Elyes-Grati/VTOL-system/docs/vtol_presentation.pdf

# VTOL

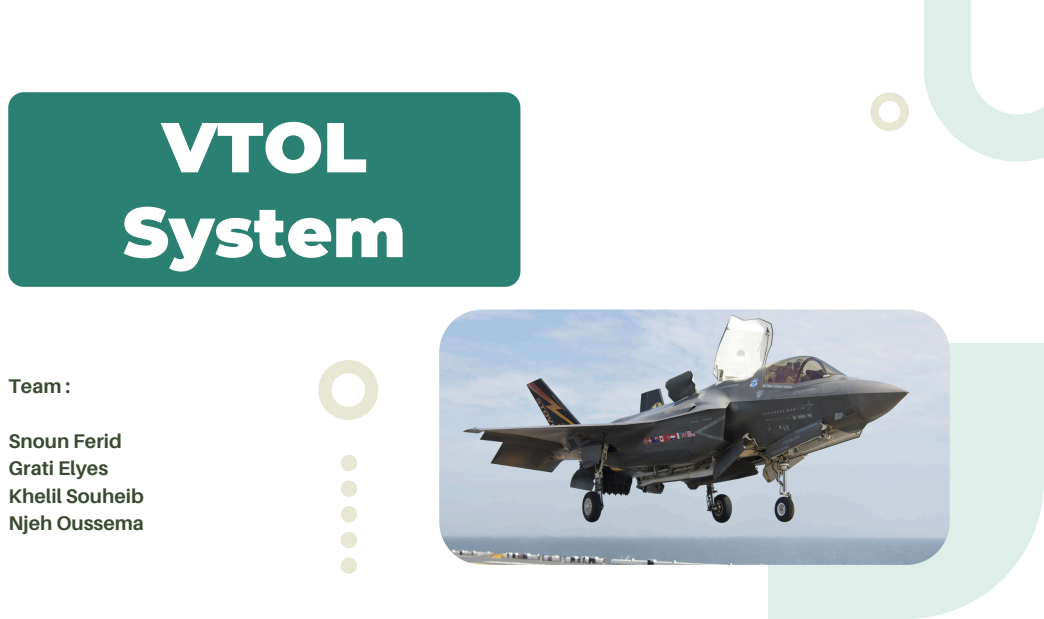
[picture p3: page 1]
System; Team :; Snoun Ferid Grati Elyes Khelil Souheib Njeh Oussema

# Who We Are: Team Introduction

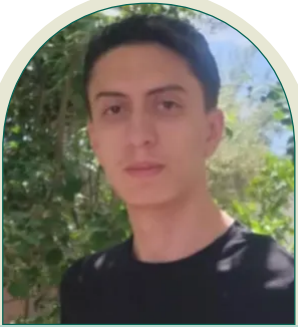
[picture p4: figure]
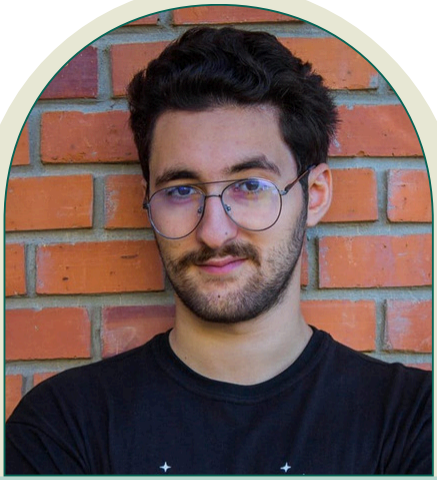
[picture p5: figure]

# IIA4

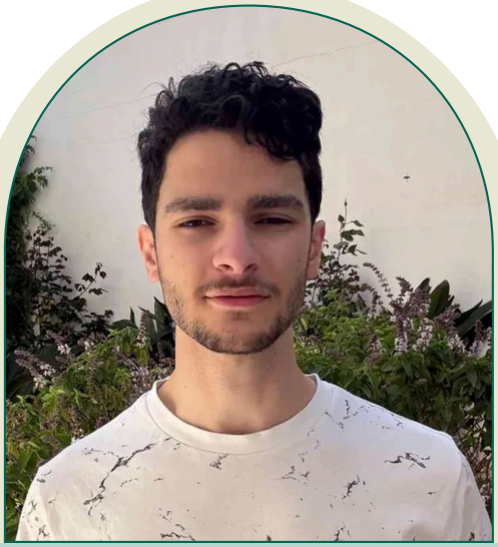
[picture p6: figure]
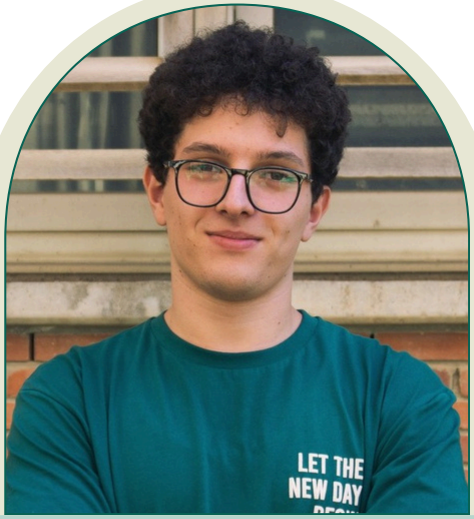
[picture p7: figure]

GRATI Elyes | NJEH Oussema | SNOUN Ferid | KHELIL Souheib

Introduction

# What Is VTOL?

VTOL stands for Vertical
Take-Off and Landing. Unlike traditional fixed-wing aircraft that require long runways to generate lift, VTOL systems can hover, take off, and land vertically.

This is achieved by orienting thrust vectors upward to
overcome | gravity | (mg)
directly. | The | benchmark
described in this document uses two thrust sources (M1 and M2) to manage both lift and roll .

# Industrial Interest and Technical Challenges

### 1. Industrial Interest

Operational Flexibility : VTOL systems eliminate the need for massive infrastructure (runways), making them ideal for urban air mobility, search and rescue in rugged terrain, and military operations on small ship decks.
Efficiency in Transition : These systems aim to combine the hovering capabilities of a helicopter with the high-speed cruise efficiency of an airplane.
Precision Logistics : They are increasingly used in the drone industry for "last-mile" delivery and autonomous inspection of industrial sites.

Strong Input Coupling : As noted in the references, VTOL systems often suffer from "Strong Input Coupling"
, where the forces intended for lift also affect the lateral movement and roll, making them difficult to stabilize.
Underactuated Dynamics : The system has fewer control inputs than degrees of freedom, requiring complex control laws to maintain balance.
Nonlinearities : Factors such as the angle of thrust and the changing roll angle create nonlinear equations of motion that are sensitive to external disturbances like wind.

# Industrial Interest and Technical Challenges

2.Technical Challenges

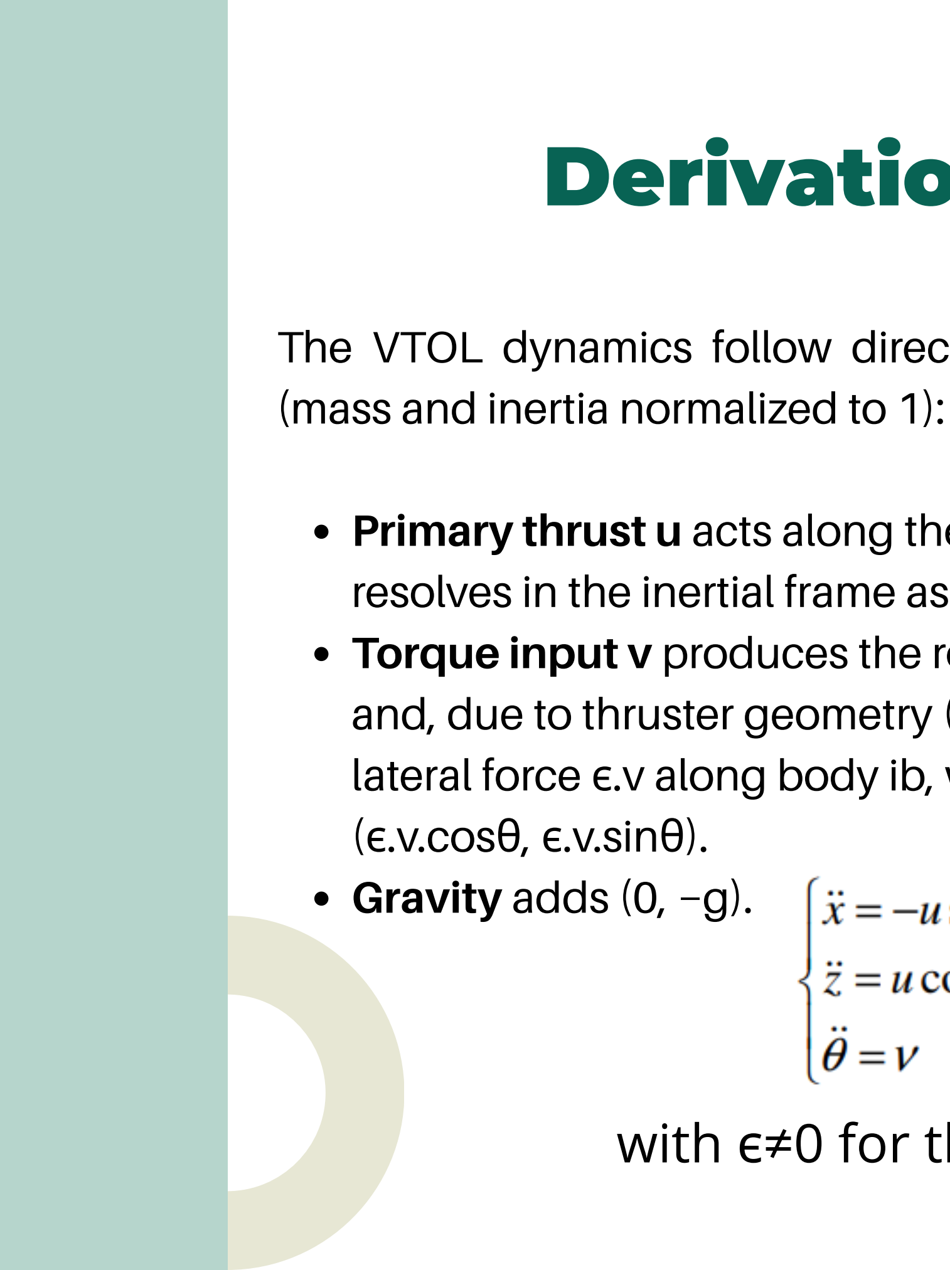
[picture p8: figure]
(mass and inertia normalized to 1):; (ϵ.v.cosθ, ϵ.v.sinθ). Gravity adds (0, −g).

The VTOL dynamics follow directly from Newton’s laws

Primary thrust u acts along the body vertical kb, which resolves in the inertial frame as (−u.sinθ, u.cosθ) . Torque input v produces the rolling acceleration = v and, due to thruster geometry (α), a small parasitic lateral force ϵ.v along body ib, which resolves as

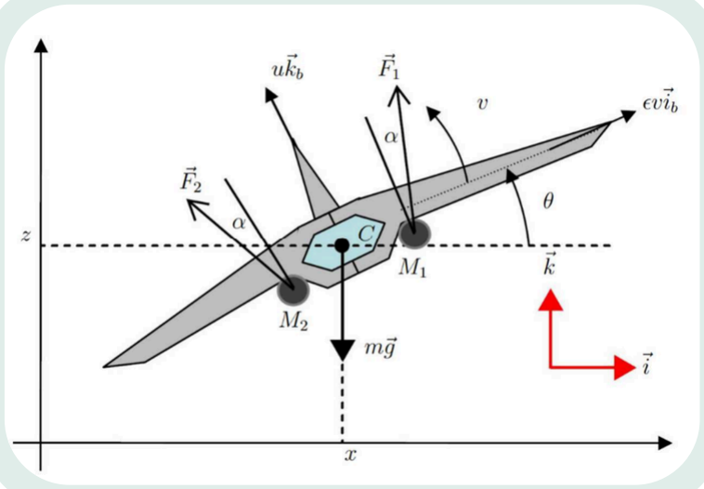
[picture p9: figure]
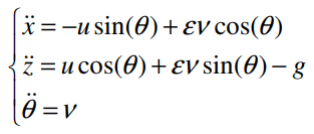
[picture p10: figure]

## with ϵ≠0 for the strong input coupling

# Derivation of the dynamics

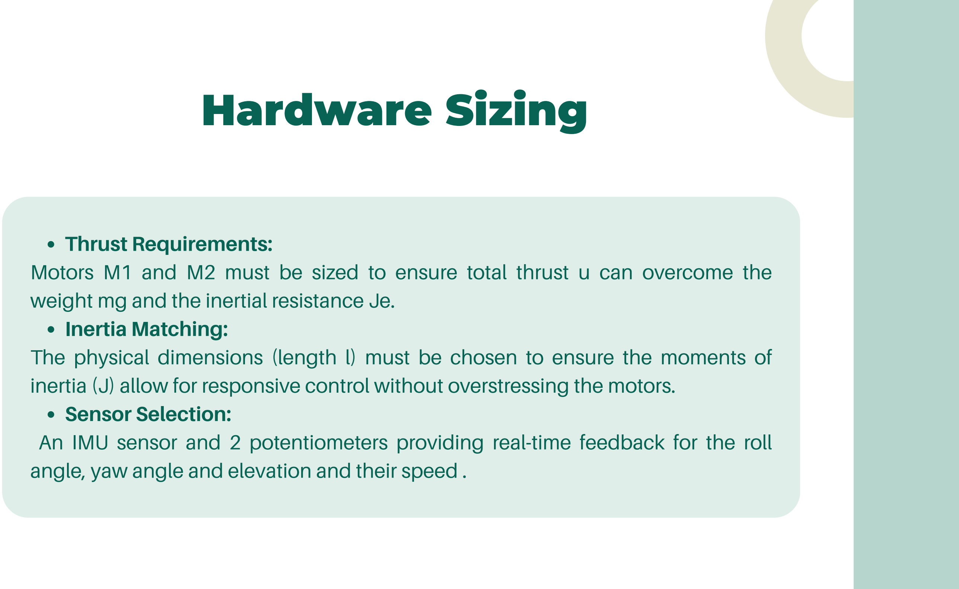
[picture p11: figure]
Hardware Sizing; Thrust Requirements:; Inertia Matching:; Sensor Selection:

Motors M1 and M2 must be sized to ensure total thrust u can overcome the weight mg and the inertial resistance Je.

The physical dimensions (length l) must be chosen to ensure the moments of inertia (J) allow for responsive control without overstressing the motors.

An IMU sensor and 2 potentiometers providing real-time feedback for the roll angle, yaw angle and elevation and their speed .

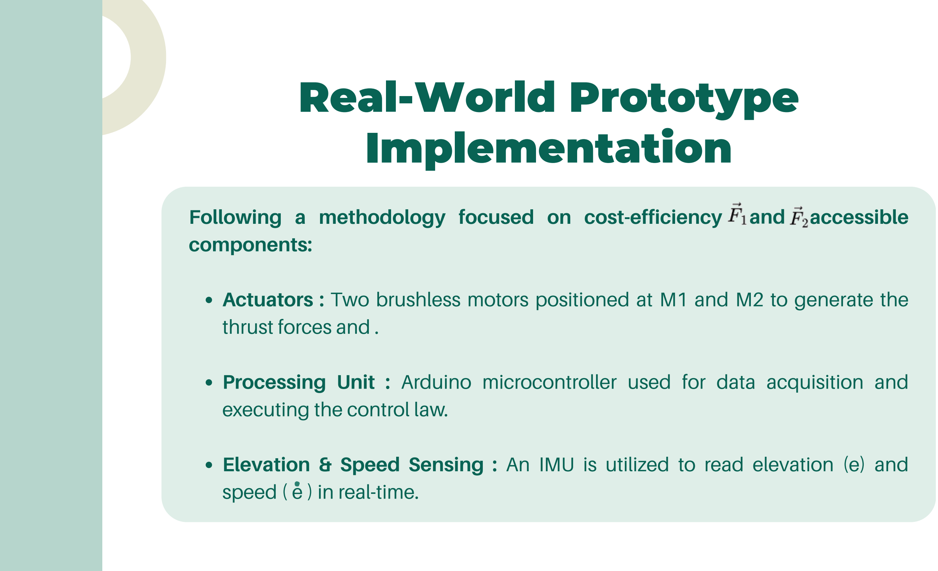
[picture p12: figure]
components:; thrust forces and .; executing the control law.; speed ( e ) in real-time.; Real-World Prototype Implementation

Following a methodology focused on cost-efficiency and accessible

Actuators : Two brushless motors positioned at M1 and M2 to generate the

Processing Unit : Arduino microcontroller used for data acquisition and

Elevation & Speed Sensing : An IMU is utilized to read elevation (e) and

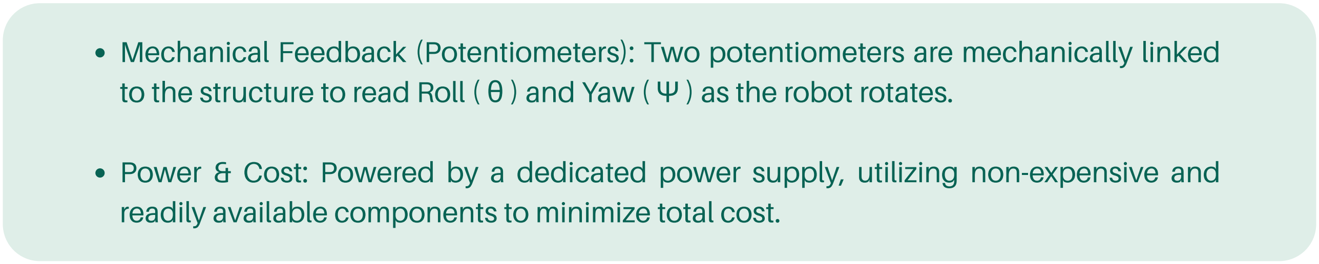
[picture p13: figure]

Mechanical Feedback (Potentiometers): Two potentiometers are mechanically linked to the structure to read Roll ( θ ) and Yaw ( Ψ ) as the robot rotates.

Power & Cost: Powered by a dedicated power supply, utilizing non-expensive and readily available components to minimize total cost.

# Real-World Prototype Implementation

Physical Feasibility : The original model describes a free-flying aircraft, which is significantly harder to stabilize and implement in a lab setting.
Supported Constraints : Our rig uses a mechanical support structure, making the 3-DOF model much easier to implement and safer to test while still capturing complex dynamics.
Axis Integration : It directly incorporates the Elevation (e), Roll ( θ ), and Yaw ( Ψ ) axes we measure using our IMU and mechanical potentiometers.

# The Transition: Why the New Model?

We transitioned from the initial benchmark dynamics to the 3-DOF Helicopter Rig model to better align with our physical setup.

# The New Dynamics

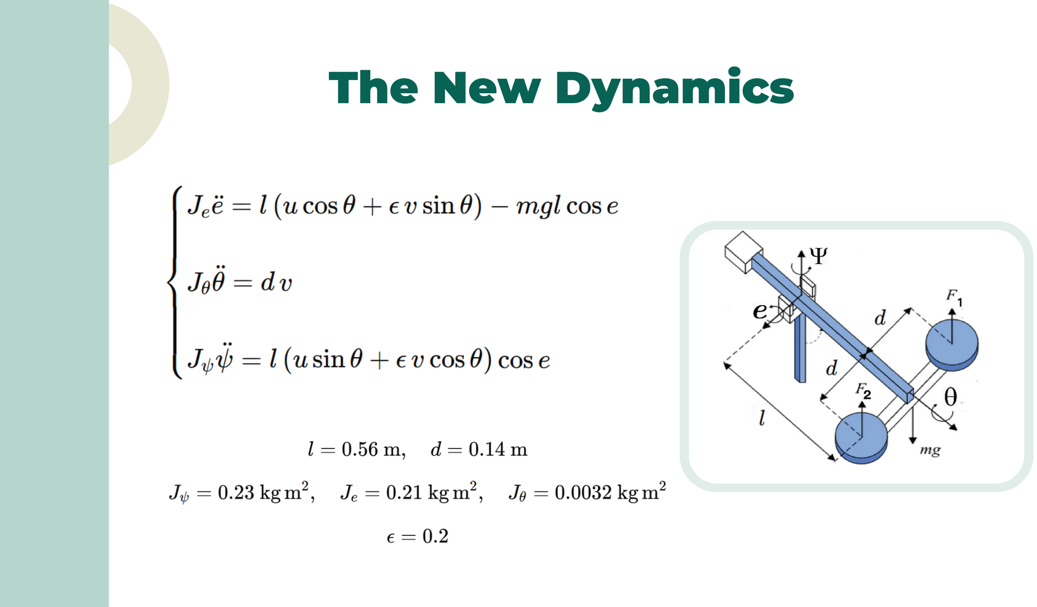
[picture p14: page 11]

# Linearized State-Dpace Representation:

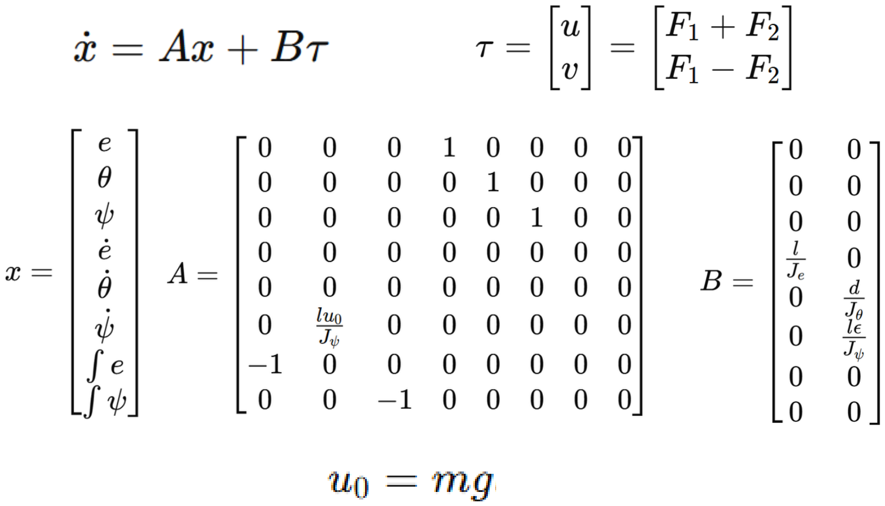
[picture p15: figure]

### The Linear Quadratic Regulator (LQR) is an optimal control method that stabilizes a linear system using state feedback u = −K.x It works by minimizing a cost function that balances state error and control effort:

### The matrices Q and R lets us tune the trade-off: higher Q prioritizes accuracy, while higher R reduces control effort. The optimal gain K is obtained by solving the Riccati equation, giving a systematic way to

design an efficient and stable controller.

### After refining the Q and R matrices, we find these values to be optimal:

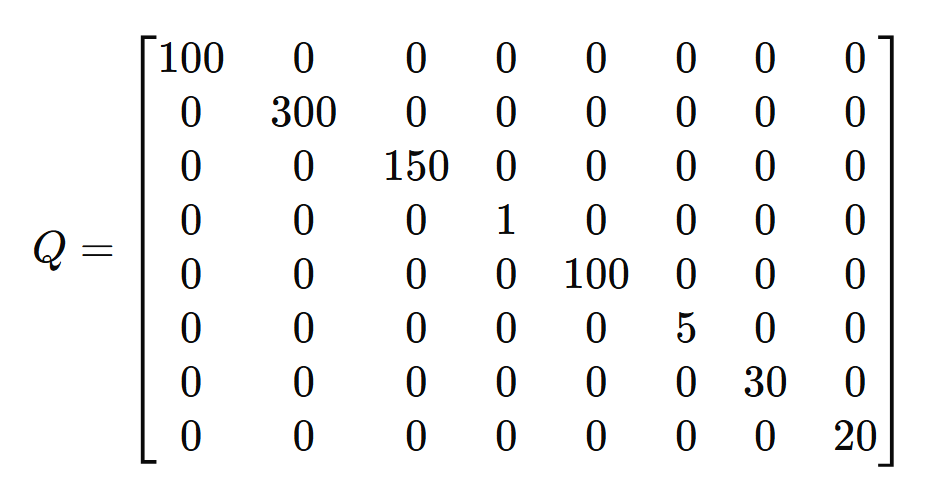
[picture p16: figure]
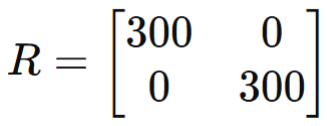
[picture p17: figure]

### Solving the Riccati equation in MATLAB yields the following values for K:

# THANK

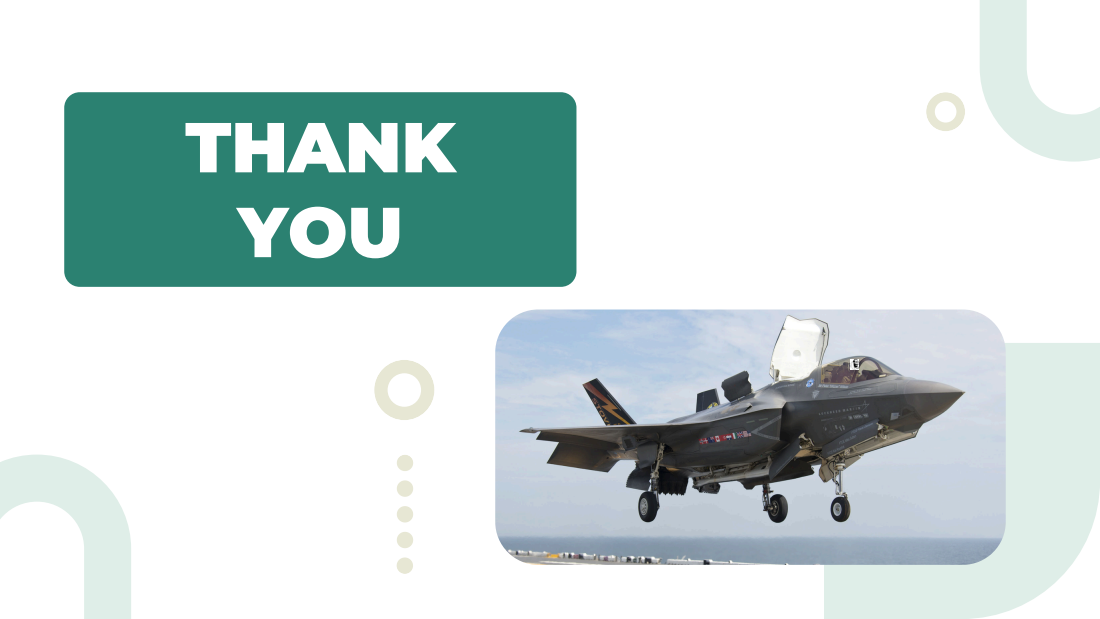
[picture p18: page 15]
YOU
